jhelvy/wireless-corne/README.md

Build log and photo gallery for my Wireless Corne keyboard

- [Gallery](https://imgur.com/gallery/pbZcbo1)
- [Build log](https://github.com/jhelvy/wireless-corne/tree/main/build)
- [3D print case files](https://github.com/jhelvy/wireless-corne/tree/main/case_files)
