jhelvy/wireless-corne/case_files/README.md

This is a tenting case for a wireless Corne.

Uses M5 bolts and nuts for tenting.

More details on thingiverse: https://www.thingiverse.com/thing:4705667

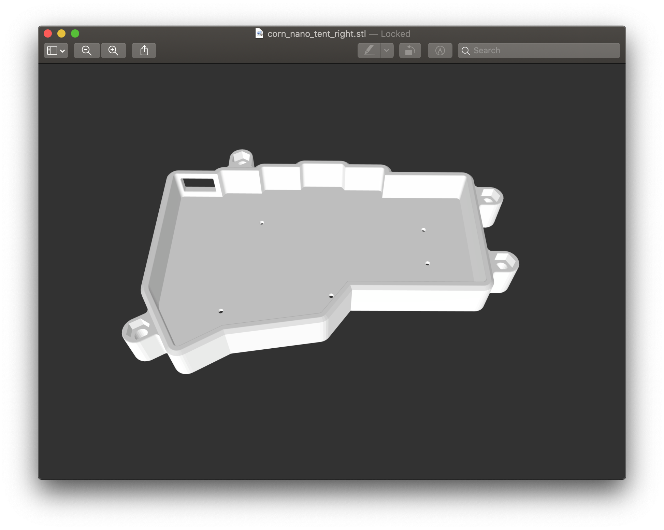
[picture p1: case_files/screenshot.png]
