jhelvy/wireless-corne/case_files/corn_nano_tent_left.stl

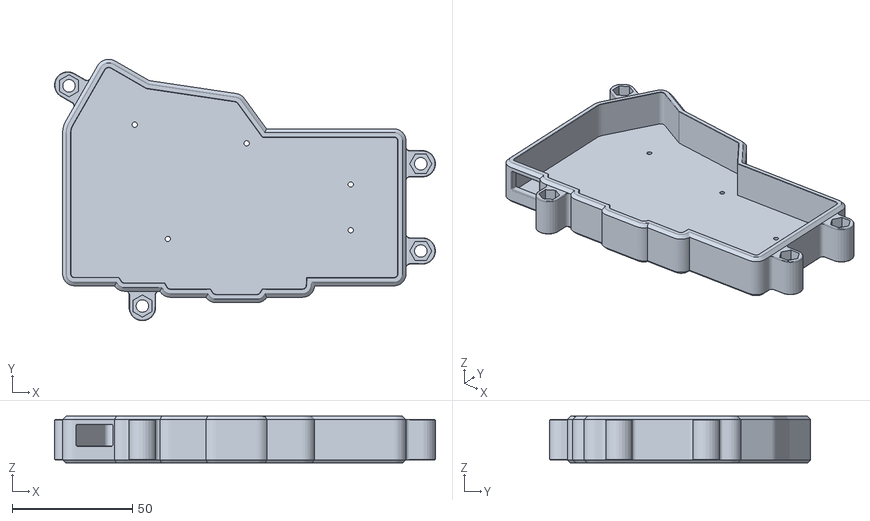
[picture p2: CAD file, 2021-07-04]
case_files/corn_nano_tent_left.stl
158.4 x 108.7 x 19.5
