jhelvy/wireless-corne/(list of files, cad)

Other CAD files:
case_files/corn_nano_tent_right.stl
