jhelvy/wireless-corne/build/images/left1.jpg

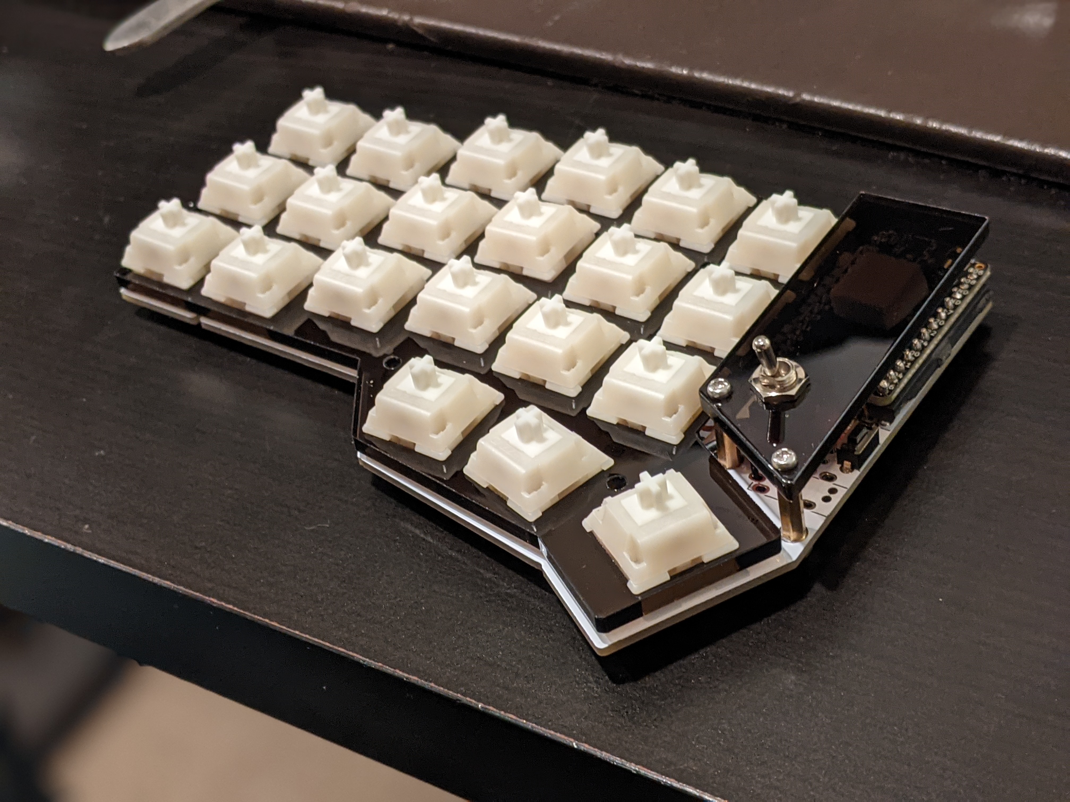
build/images/left1.jpg
