jhelvy/wireless-corne/build/images/left2.jpg

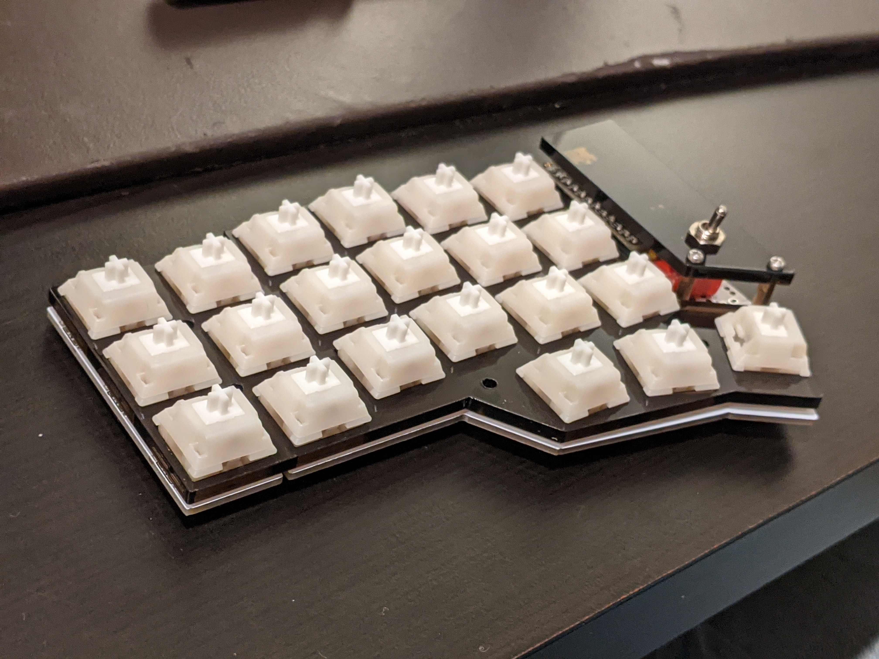
build/images/left2.jpg
