jhelvy/wireless-corne/build/images/mounted1.jpg

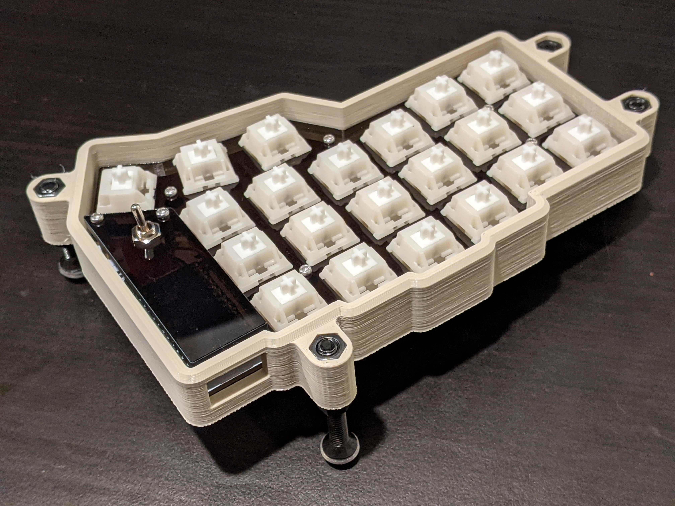
build/images/mounted1.jpg
