jhelvy/wireless-corne/build/images/mounted2.jpg

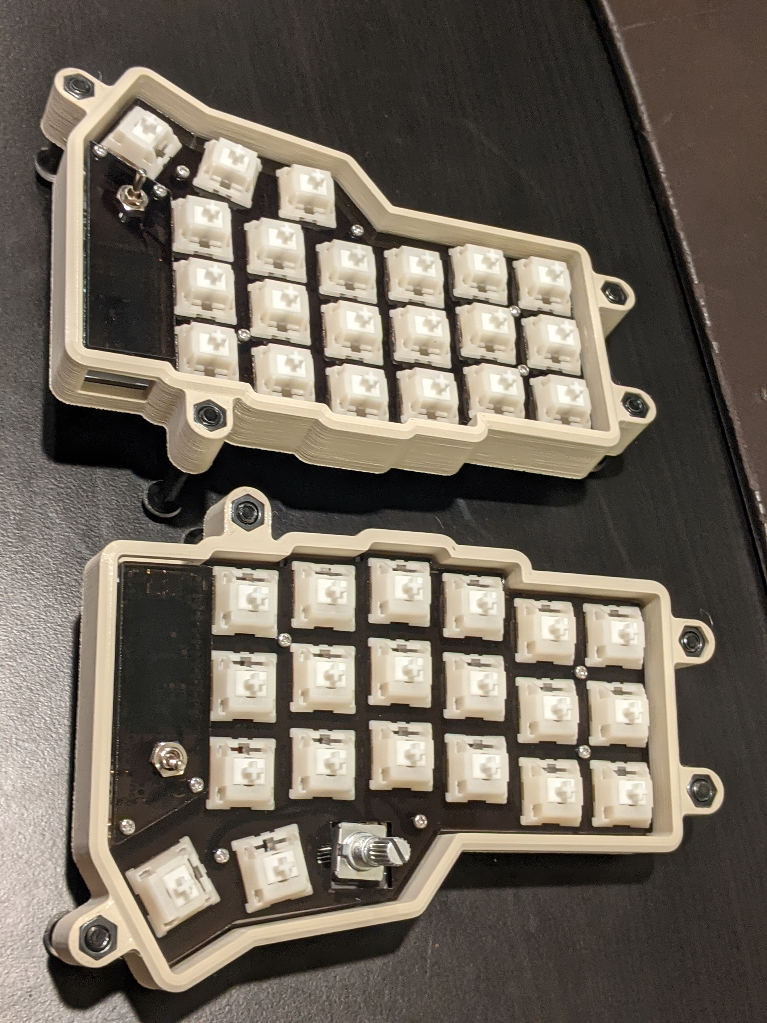
build/images/mounted2.jpg
