jhelvy/wireless-corne/build/images/right.jpg

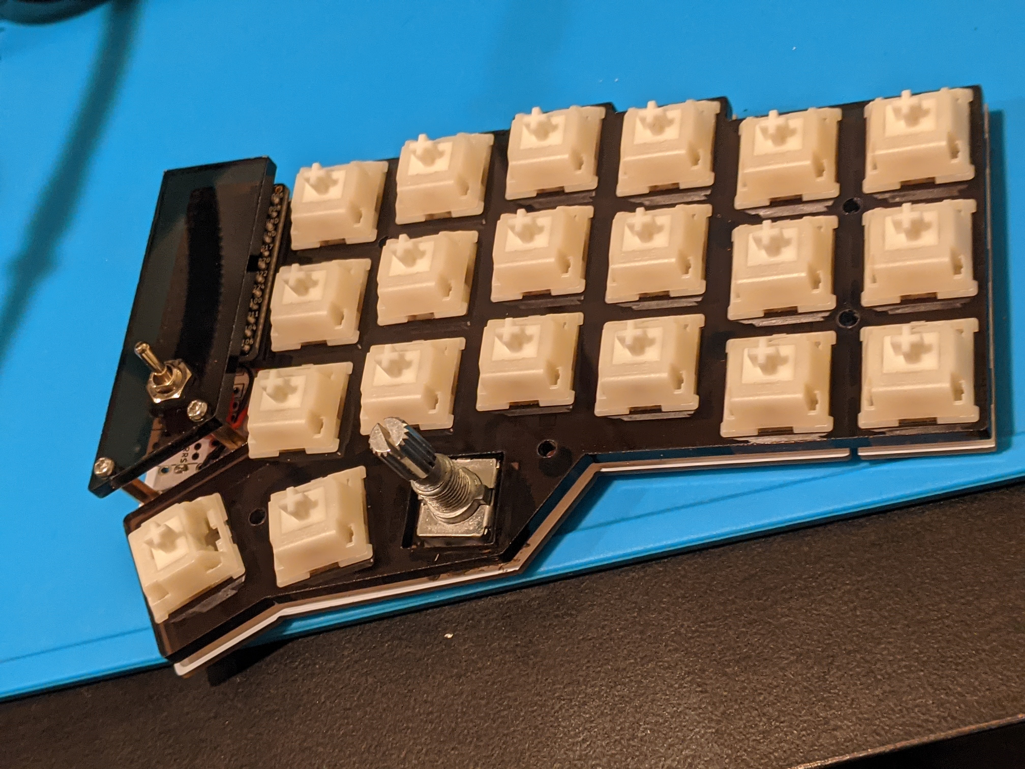
build/images/right.jpg
